peltonen/valveDriver/Valve Driver V4.1.brd

## EAGLE design Valve Driver V4.1.brd (2014-03-22)

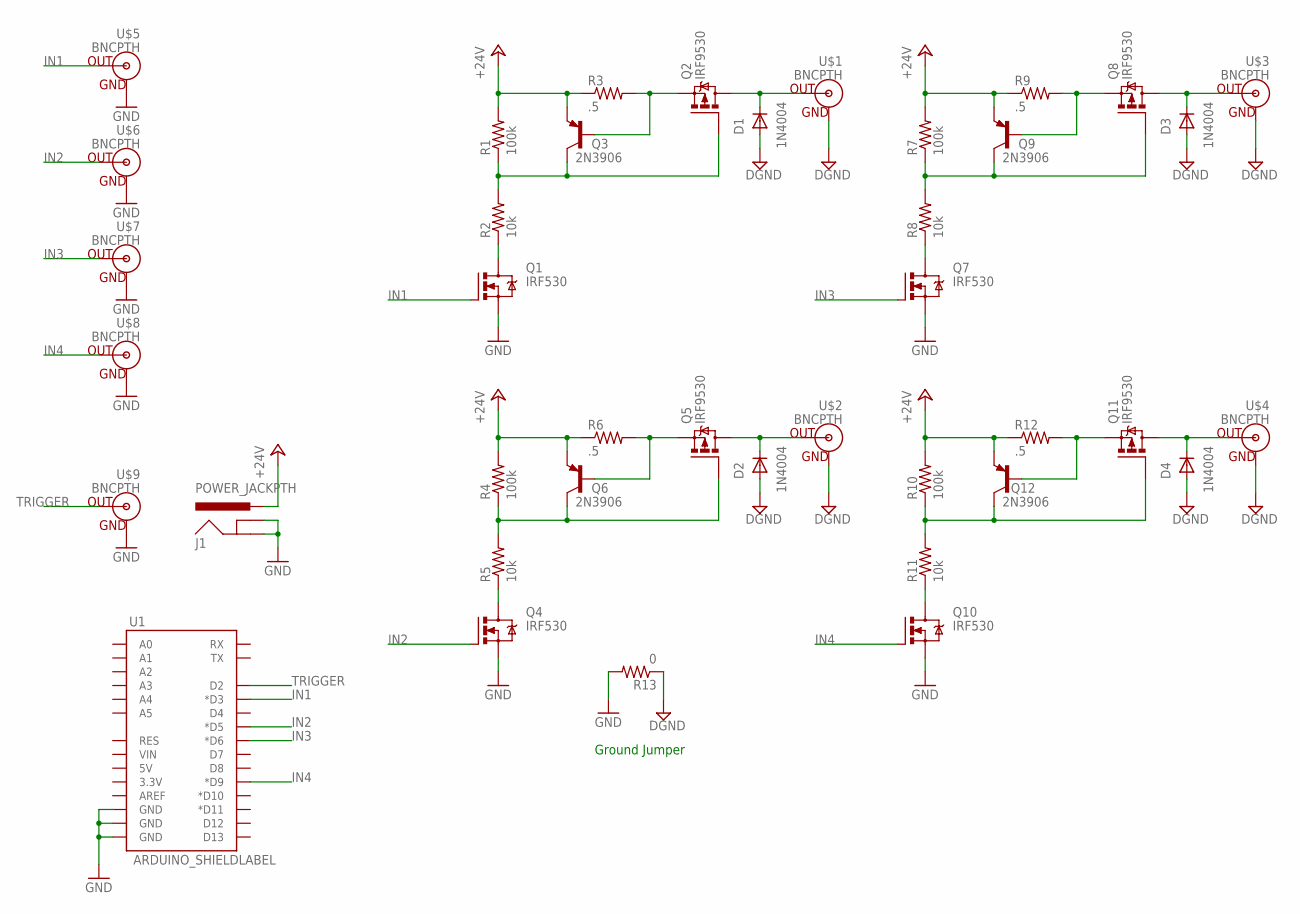
[picture p1: schematic Valve Driver V4.1.sch]

Parts:
D1, D2, D3, D4: 1N4004; DO41-10
J1: POWER_JACKPTH; POWER_JACK_PTH
Q1, Q4, Q7, Q10: IRF530; TO220BV
Q2, Q5, Q8, Q11: IRF9530; TO220BV
Q3, Q6, Q9, Q12: 2N3906; TO92
R1, R4, R7, R10: 100k; AXIAL-0.4
R2, R5, R8, R11: 10k; AXIAL-0.4
R3, R6, R9, R12: .5; AXIAL-0.4
R13: 0; AXIAL-0.4
U1: ARDUINO_SHIELDLABEL; DUEMILANOVE_SHIELD
U$1, U$2, U$3, U$4, U$5, U$6, U$7, U$8, U$9: BNCPTH; BNC

Connections:
+24V: J1.PWR, Q3.3 (E), Q6.3 (E), Q9.3 (E), Q12.3 (E), R1.P$2 (2), R3.P$1 (1), R4.P$2 (2), R6.P$1 (1), R7.P$2 (2), R9.P$1 (1), R10.P$2 (2), R12.P$1 (1)
DGND: D1.A, D2.A, D3.A, D4.A, R13.P$1 (1), U$1.GND, U$2.GND, U$3.GND, U$4.GND
GND: J1.GND, J1.GNDBREAK, Q1.S, Q4.S, Q7.S, Q10.S, R13.P$2 (2), U1.GND@0 (GND), U1.GND@1 (GND), U1.GND@2 (GND), U$5.GND, U$6.GND, U$7.GND, U$8.GND, U$9.GND
IN1: Q1.G, U1.D3 (*D3), U$5.S (OUT)
IN2: Q4.G, U1.D5 (*D5), U$6.S (OUT)
IN3: Q7.G, U1.D6 (*D6), U$7.S (OUT)
IN4: Q10.G, U1.D9 (*D9), U$8.S (OUT)
unnamed: Q2.G, Q3.1 (C), R1.P$1 (1), R2.P$2 (2)
unnamed: Q1.D, R2.P$1 (1)
unnamed: Q2.S, Q3.2 (B), R3.P$2 (2)
unnamed: D1.C, Q2.D, U$1.S (OUT)
unnamed: Q5.G, Q6.1 (C), R4.P$1 (1), R5.P$2 (2)
unnamed: Q4.D, R5.P$1 (1)
unnamed: Q5.S, Q6.2 (B), R6.P$2 (2)
unnamed: D2.C, Q5.D, U$2.S (OUT)
unnamed: Q8.G, Q9.1 (C), R7.P$1 (1), R8.P$2 (2)
unnamed: Q7.D, R8.P$1 (1)
unnamed: Q8.S, Q9.2 (B), R9.P$2 (2)
unnamed: D3.C, Q8.D, U$3.S (OUT)
unnamed: Q11.G, Q12.1 (C), R10.P$1 (1), R11.P$2 (2)
unnamed: Q10.D, R11.P$1 (1)
unnamed: Q11.S, Q12.2 (B), R12.P$2 (2)
unnamed: D4.C, Q11.D, U$4.S (OUT)
TRIGGER: U1.D2, U$9.S (OUT)

Notes on the sheet:
Ground Jumper

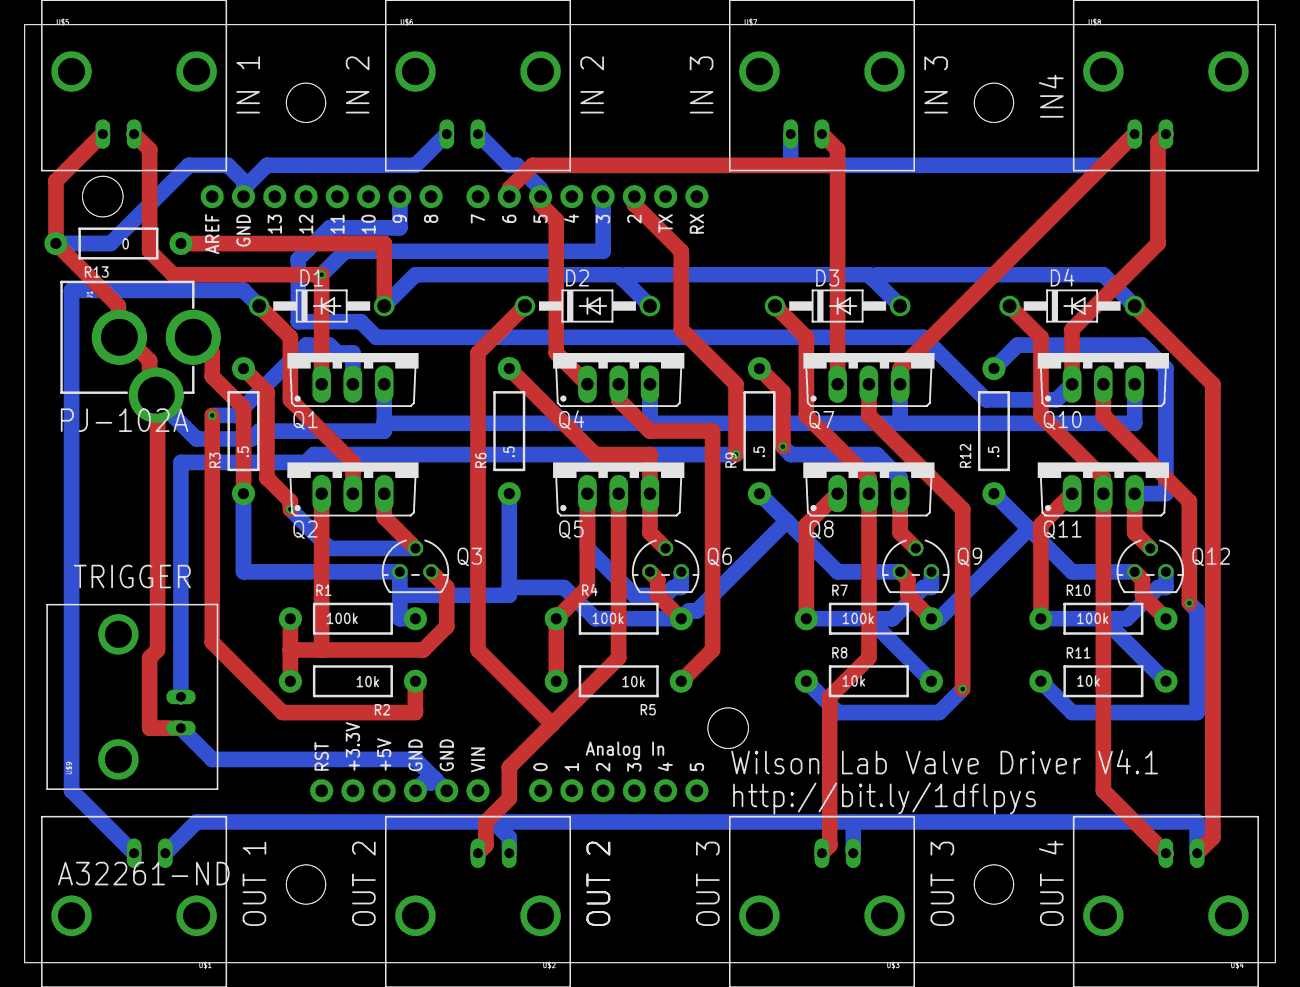
[picture p2: board Valve Driver V4.1.brd from above]

Board: 2 copper layers, 101.6 x 76.2 mm, 40 parts (0 on the bottom side), 24 nets.
