peltonen/valveDriver/valveDriverInstructions.rtf

Valve Driver v4.1 Board URL - http://bit.ly/1dflpys

This board allows controlling of 4 solenoid valves (or other high-current devices) from a computer. On receiving a logic HI on an input channel, the board will bring the pin of the output channel to the power supply voltage. Outputs are current limited to protect against short circuits.

There are two ways to use the board:

(1) Valves connected to each output can be triggered by supplying a 5V signal to the corresponding input.

(2) A programmable USB Arduino prototyping board (www.arduino.cc), can be attached to the bottom of the board, and outputs of the Arduino are connected to the input lines. (A BNC connector for a TRIGGER input for the Arduino is also provided.) Thus, sketches running on the Arduino can trigger valve openings.

Arduino Pin Out:

Programming Arduino is beyond the scope of this document, but the key facts you’ll need are:

TRIGGER - Arduino Pin D2
IN1 - Arduino Pin D3
IN2 - Arduino Pin D5
IN3 - Arduino Pin D6
IN4 - Arduino Pin D9

Also note that the Arduino uses the same 2.1 mm power connector, but will be destroyed by 24V. So don’t plug a 24 V supply into your Arduino by accident.

Building the Board:

The Wilson Lab has some extras in storage. If you only want 1 or 2, contact them to see if they’ll give you one. Otherwise you’ll need to make your own. A batch of 5 can be made in 2 weeks, for about $100, and all the files you’ll need are provided.

Files are here:

https://github.com/joebell/valveDriver
(https://drive.google.com/file/d/0B7uBwBiCIUHtYlAyUGN5XzAydUE/edit?usp=sharing)
The git repo contains the Eagle schematics and board layout, as well as a directory with all of the gerber files necessary for fabrication. Of note are:

.top | Top copper traces
.bot | Bottom copper traces
.oln | Board outline
.slk | Top silkscreen
.smt | Top soldermask
.smb | Bottom soldermask
.drd | NC drill data

You can upload these to a PCB fab house to have a small number of boards made. I like Sunstone and Silvercircuits.

You’ll also need to order parts, most of which are available at Digikey. For each 4 ch. board you’ll need:

Part Desc. | Digikey Part # | Qty (each)
Arduino UNO | 1050-1041-ND | 1
Power Jack | CP-102A-ND | 1
BNC Jack | A32261-ND | 5 - 9
Breakaway header | WM50018-36-ND | 1
IRF530 | IRF530PBF-ND | 4
IRF9530 | IRF9530PBF-ND | 4
2N3906 | 2N3906-APCT-ND | 4
1N4004 | 1N4004DICT-ND | 4
.5 ohm | WNBR50FECT-ND | 4
100 kohm | CF14JT100KCT-ND | 4
10 kohm | CF14JT10K0CT-ND | 4
Standoffs 4-40 | 2031K-ND or 4806K-ND | 4
Screws, 4-40 | (McMaster Carr) | 4
Power supply (24V) | 237-1459-ND | 1

To build the board, stuff appropriate parts into the board, solder them. Note that the transistors (Q1-12) and the diodes (D1-4) are polarized, so line them up with the silkscreen correctly. You’ll also need to snap the breakaway headers into appropriate lengths.

Finally, add a wire across R13 (in the upper left corner of the board) to reference the power supply ground to signal ground. You can allow the grounds to float relative to each other by raising the value of this resistor, but this shouldn’t be necessary.

⅛” holes are supplies for mounting with standoffs. I’d suggest 1” so you have clearance for an Arduino.

Modifications

If you’re not using some feature of the board (some channels, channel BNC inputs, the arduino headers) you can leave those features off without hurting anything.

If you want to change the current limit for each channel, choose a different value for R3,6,9,12.

The board will run with supply voltages between about 6V and 48V, just use a different power supply. You might be able to go higher, but be careful.
