peltonen/valveDriver/(commit log)

2014-03-22 Moved files around
    [Valve Driver V4.1.brd, Valve Driver V4.1.sch]
2014-04-25 Updated BOM to correct power supply. Old supply was pin-negative. Correct is pin-positive
2014-12-25 added Arduino control sketch
